pdomi2001/IOT_project/img/modulo_iot_sensore_dh11.jpg

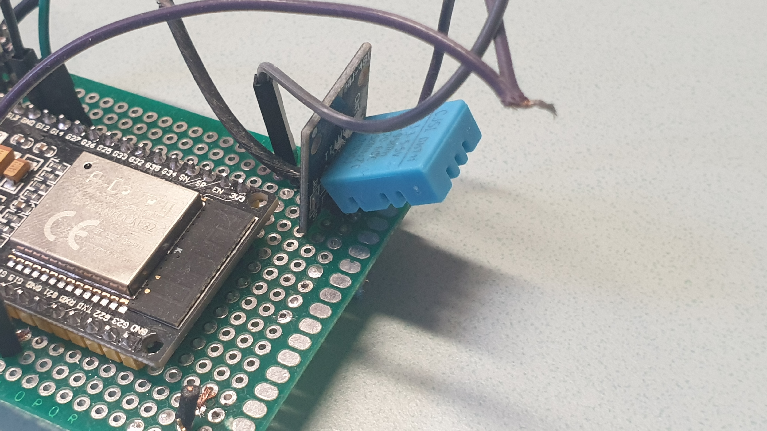
img/modulo_iot_sensore_dh11.jpg
