pdomi2001/IOT_project/img/modulo_iot_connettore.jpg

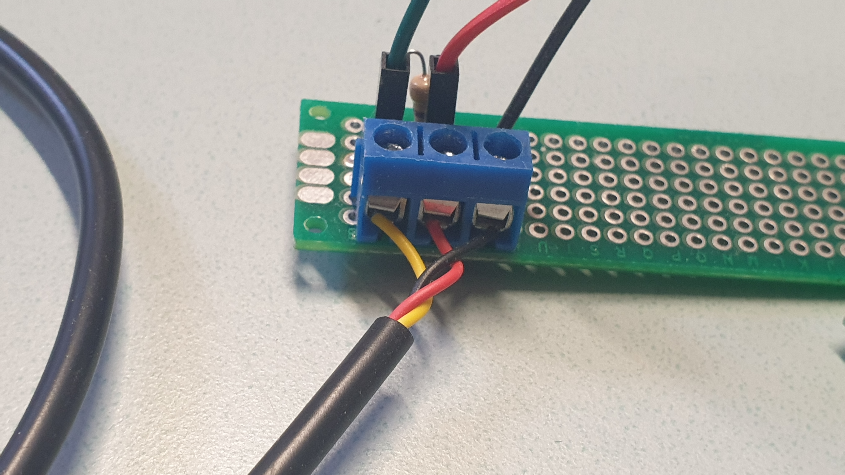
img/modulo_iot_connettore.jpg
