pdomi2001/IOT_project/presentazione/presentazione_progetto.pdf

# Esame di Internet of Things

# Stazione di rilevamento temperatura ed umidità

# Paride Dominici

# Scopo del progetto

# - Idea iniziale

# – Contabilizzatore di calore

# - Idea definitiva

# – Comparazione efficienza termosifone Vs pompa di calore

Esame di IOT – Paride Dominici | 2/27

# Contabilizzatore di calore/1

## La contabilizzazione del calore può essere effettuata nel modo seguente: 1.Si fissa una temperatura minima per considerare che il termosifone sia in funzione

2.Si fissa la differenza di tempo per far avanzare il conteggio.

## 3.Quando la temperatura rilevata supera la temperatura minima vuol dire che il

termosifone è acceso e quindi iniziamo a contare.

## 4.Finché la temperatura rimane al di sopra della temperatura minima ogni delta di

tempo facciamo avanzare il numero di elementi contati.

# Contabilizzatore di calore/2

# Caratteristiche di un contabilizzatore commerciale:

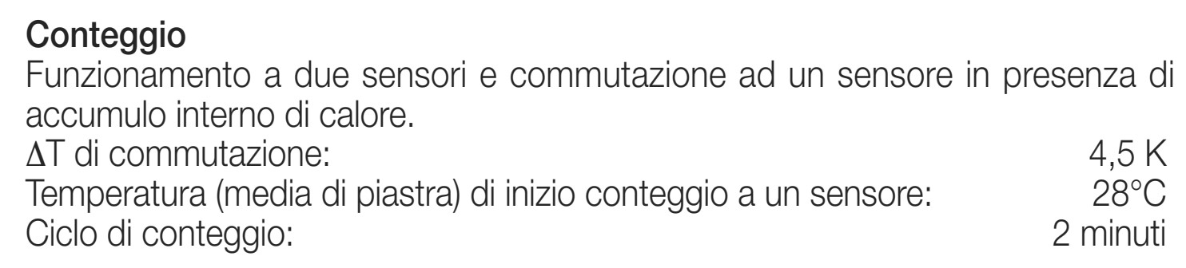
[picture p16: figure]
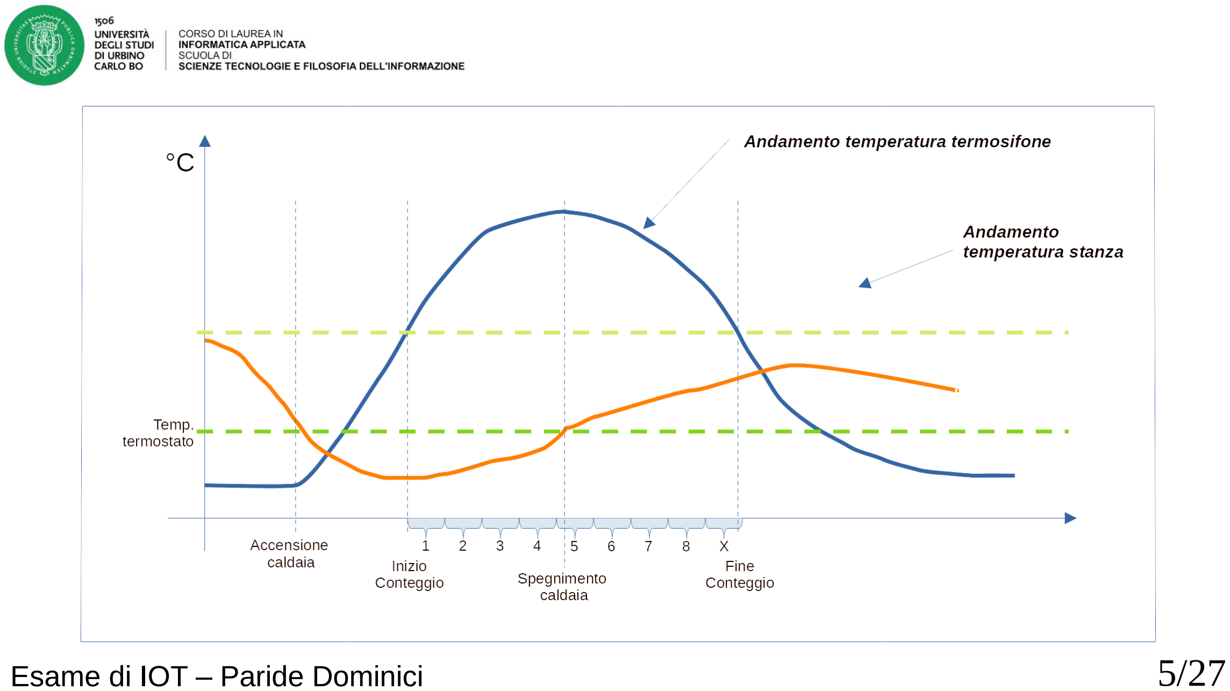
[picture p17: page 5]

# Comparazione efficienza di un termosifone contro efficienza di una pompa di calore

# Usiamo i differenti moduli per misurare le temperature del termosifone (idea iniziale) e dell’ambiente circostante e le

confrontiamo con quelle registrate dagli altri due moduli.

# Nello specifico facciamo un confronto tra l’efficienza del

termosifone e quella di una pompa di calore.
Il modulo lontano dai primi due serve come riferimento.

# Ambiente del test

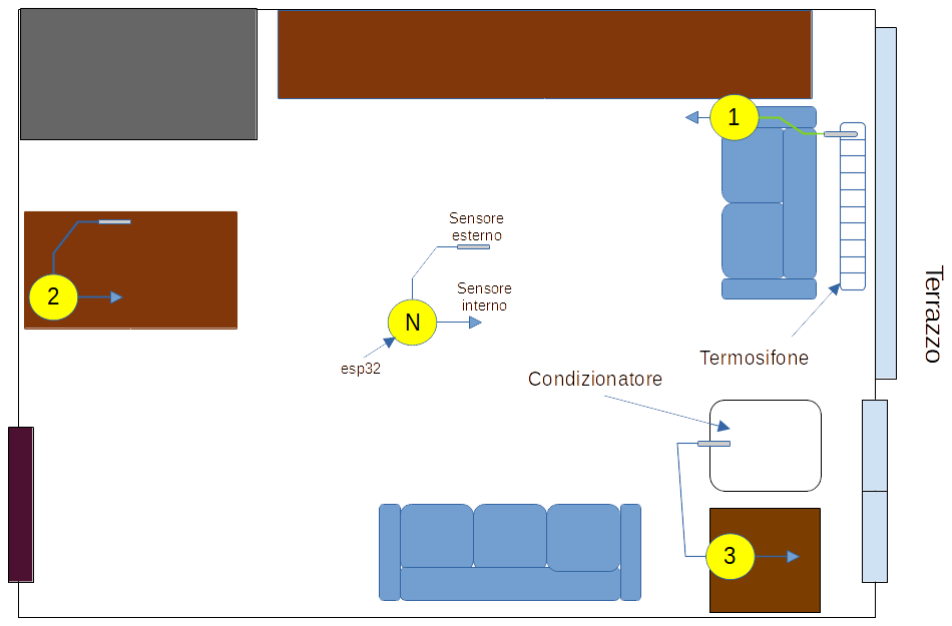
[picture p18: figure]

# Schema di collegamento dei moduli

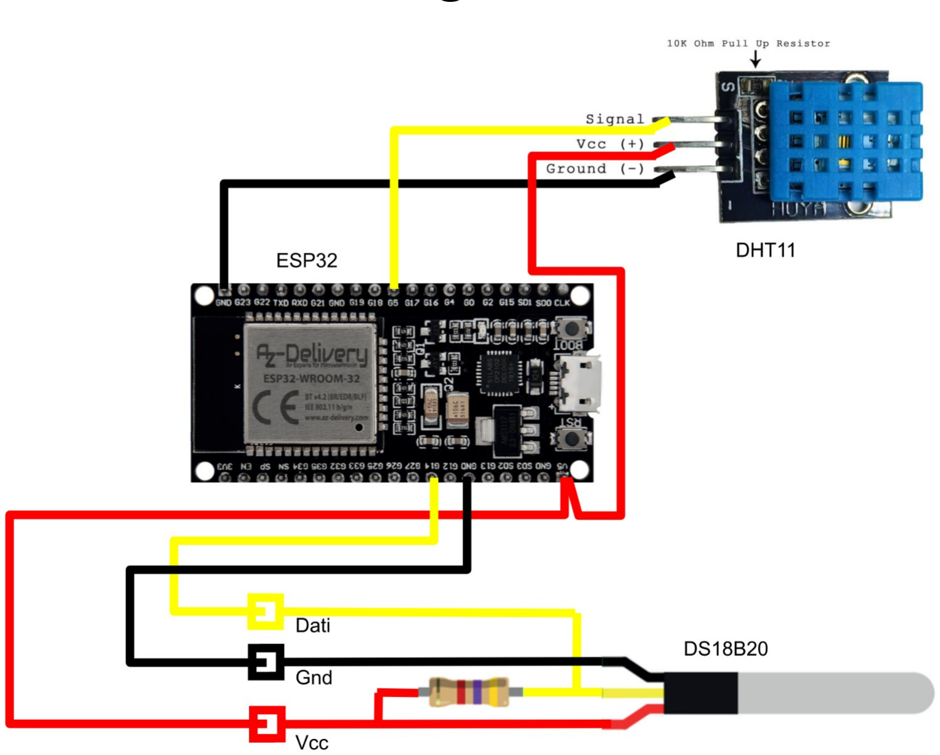
[picture p19: figure]

# Moduli/1

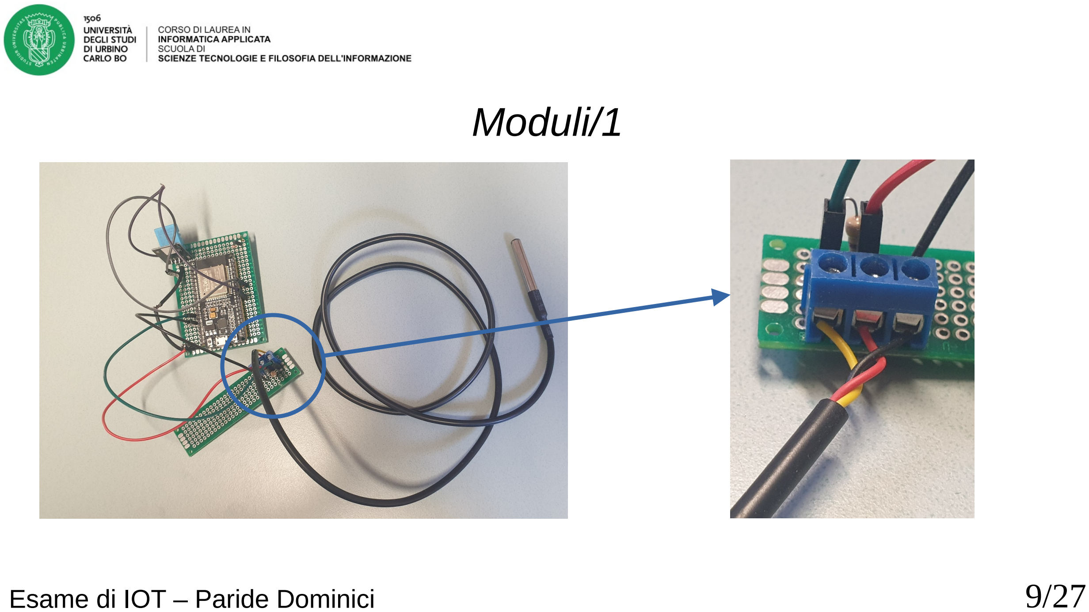
[picture p20: page 9]

# Moduli/2

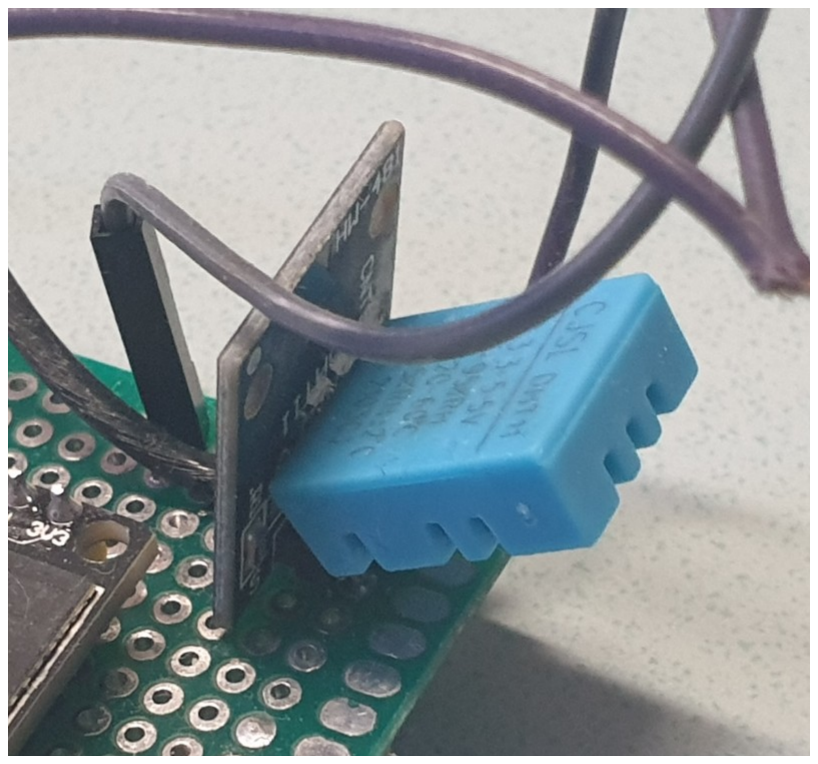
[picture p21: figure]
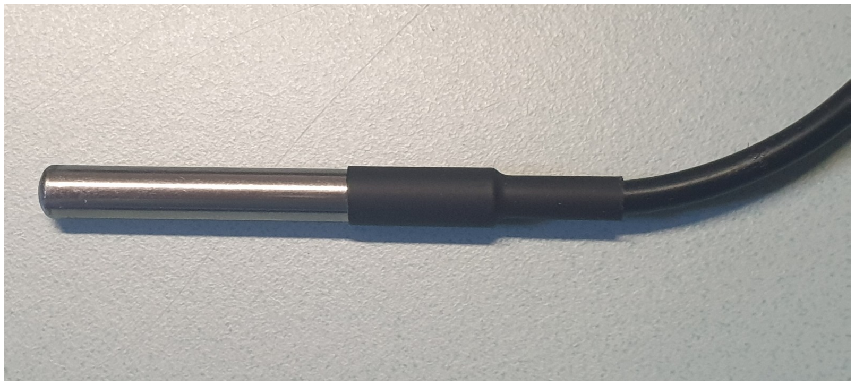
[picture p22: figure]

DS18B20 | DH11

# Modulo di ricezione dei dati/1

# - Access point WiFi

# – Servizio hostapd => Accetta le connessioni in entrata – Servizio dnsmasq => distribuisce gli indirizzi IP in modo dinamico con DHCP – Per collegarci usiamo ssh e vnc

# Modulo di ricezione dei dati/2 - Servizi di ricezione dati dai moduli

# – Tentativo di installazione InfluxDB (su architettura arm solo versione < 2.0) – Installazione broker MQTT (mosquitto) – Creazione del subscriber che raccoglie i dati (python)

## - Libreria python paho-mqtt

# – Analisi dei dati

## - Utilizzo di Pandas e Matplotlib

# Modulo di trasmissione dei dati/1

# - Usiamo delle esp32

# – Tentativo di installazione InfluxDB (solo versione < 2.0 su architettura arm) – Installazione broker MQTT (mosquitto) – Creazione dei subscriber (python)

## - Libreria python paho-mqtt

# – Analisi dei dati

## - Utilizzo di Pandas e Matplotlib

# Modulo di trasmissione dei dati/2

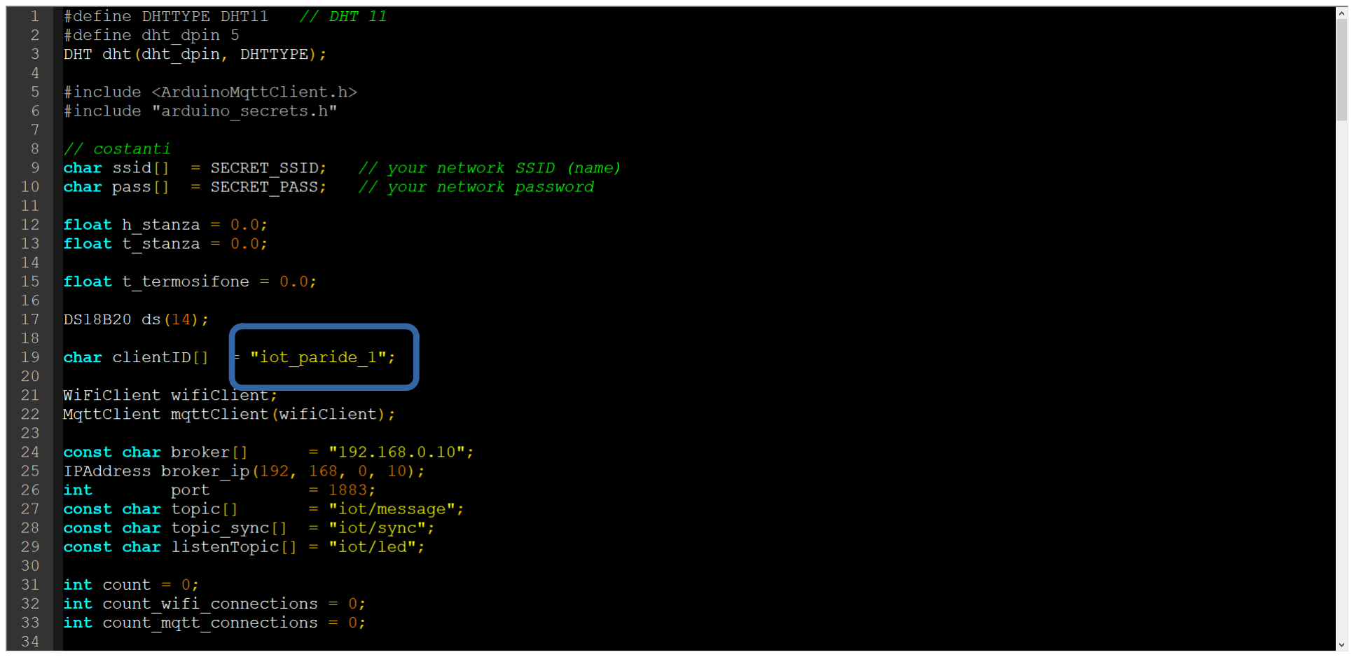
[picture p23: figure]

# Subscriber MQTT/1

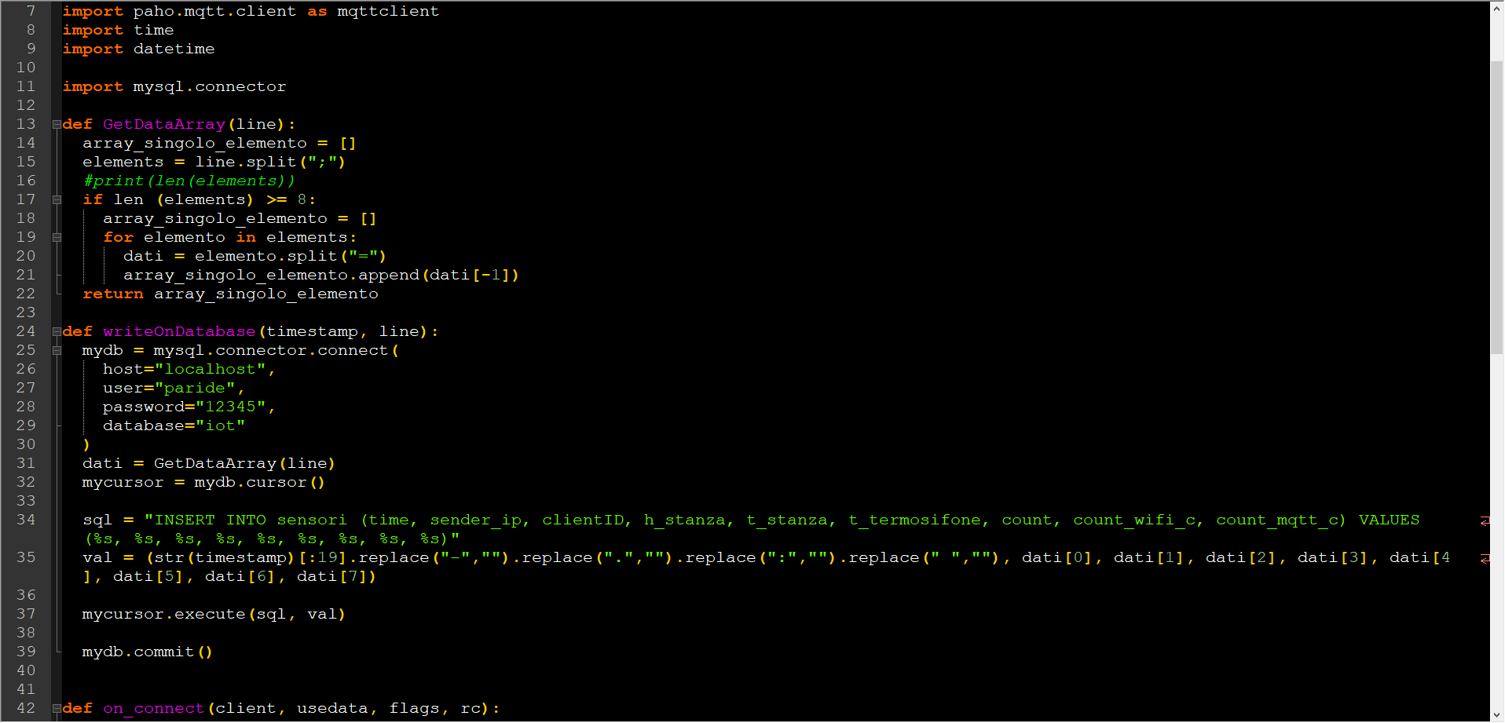
[picture p24: figure]

# Subscriber MQTT/2

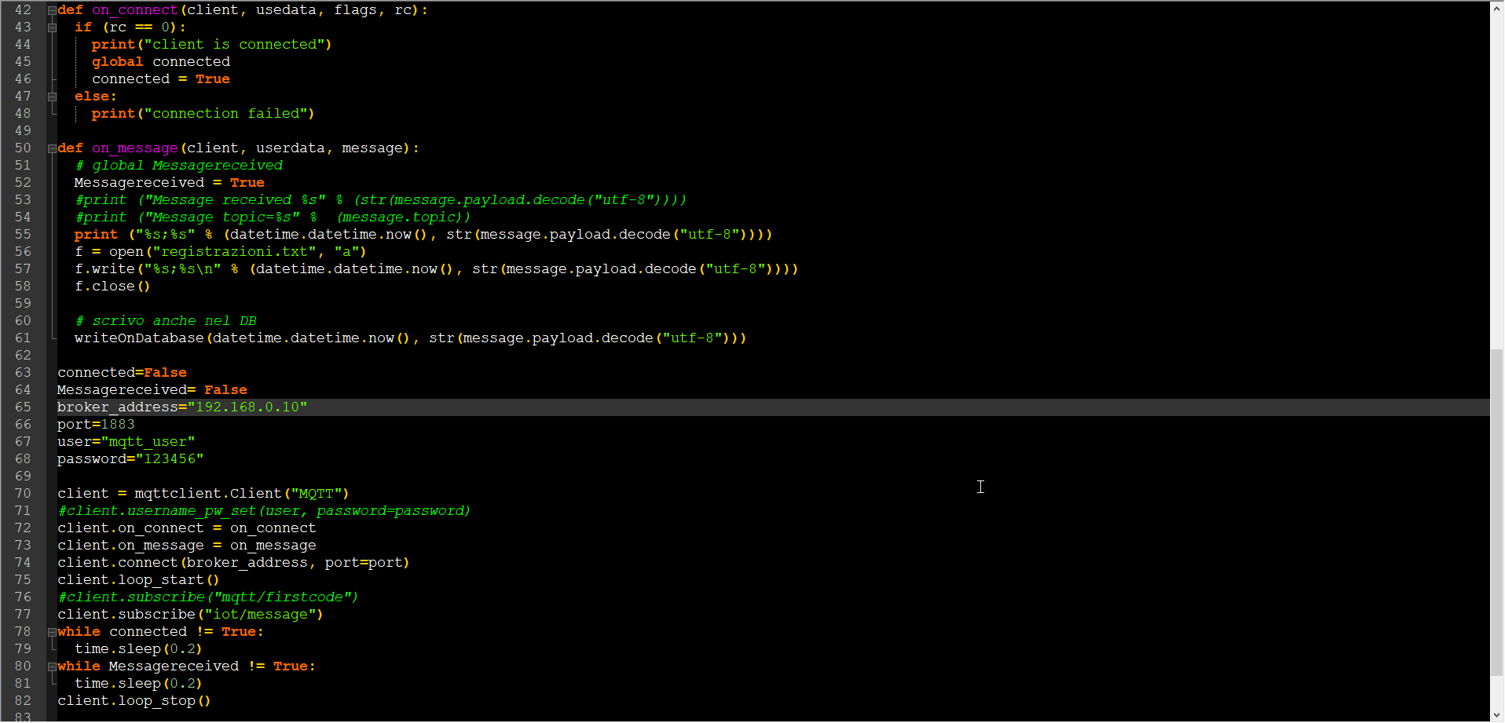
[picture p25: figure]

# File di testo con i dati ricevuti

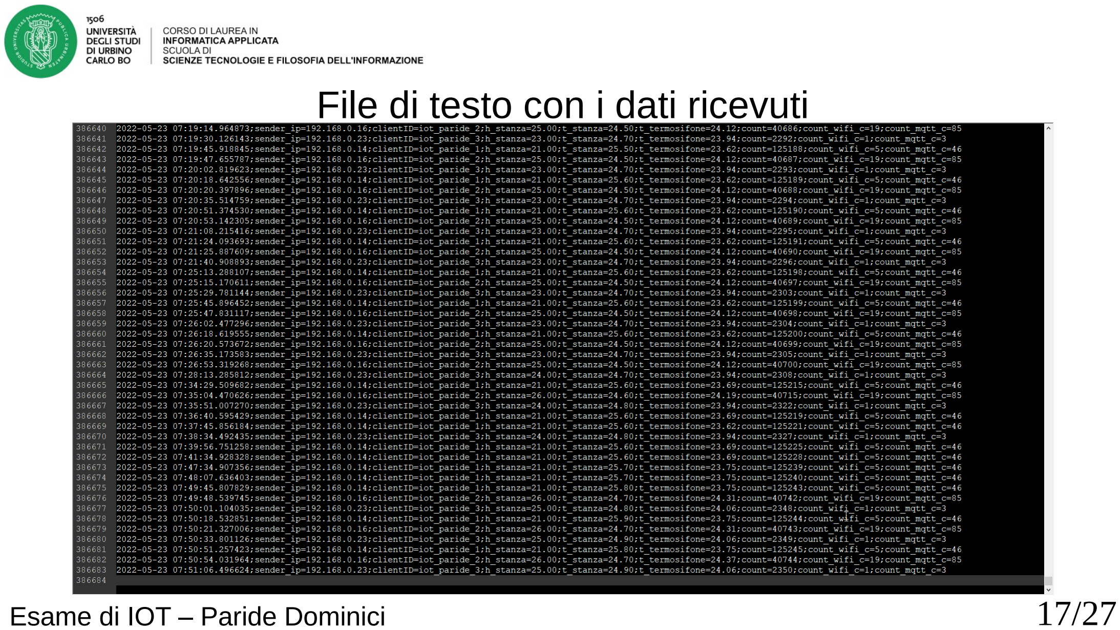
[picture p26: page 17]

# Convertitore del file per Pandas

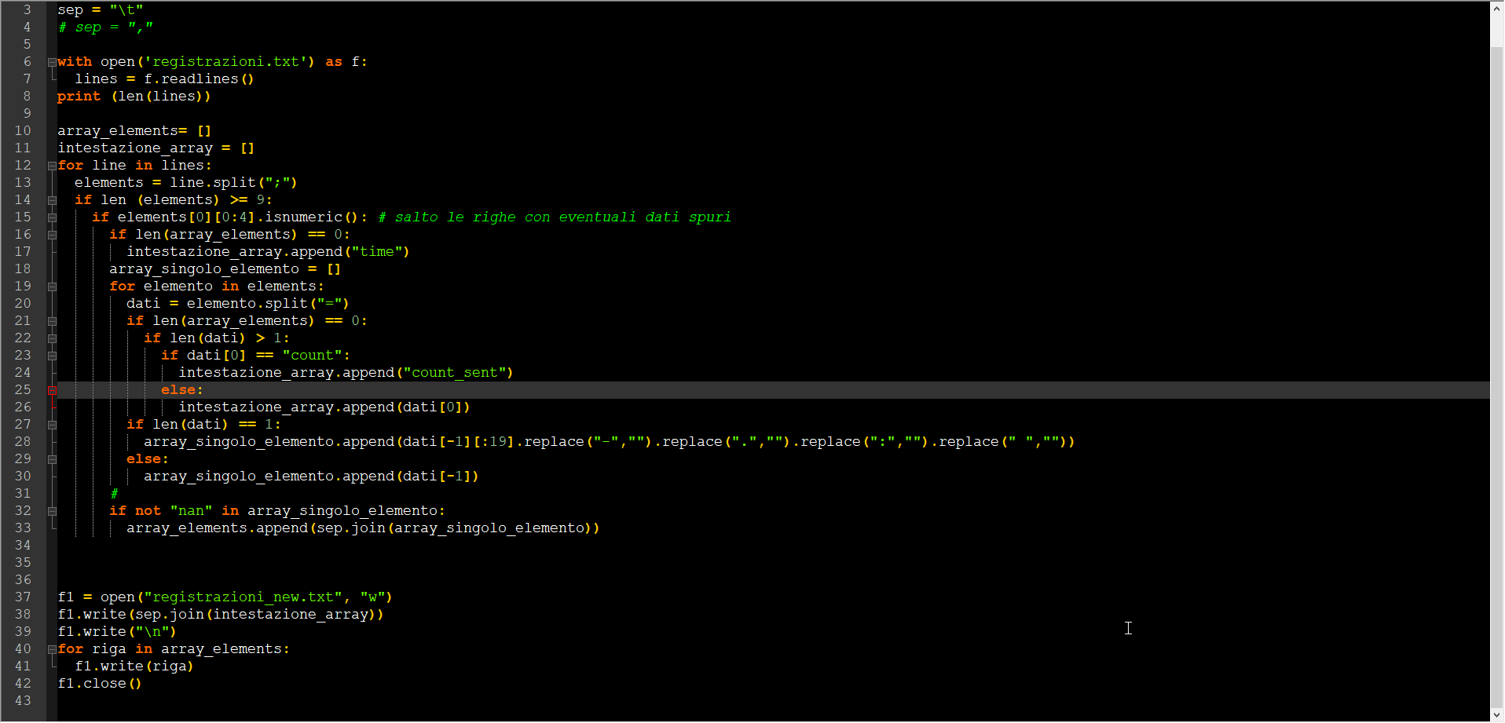
[picture p27: figure]

# File dei dati pronto per essere usato da Pandas

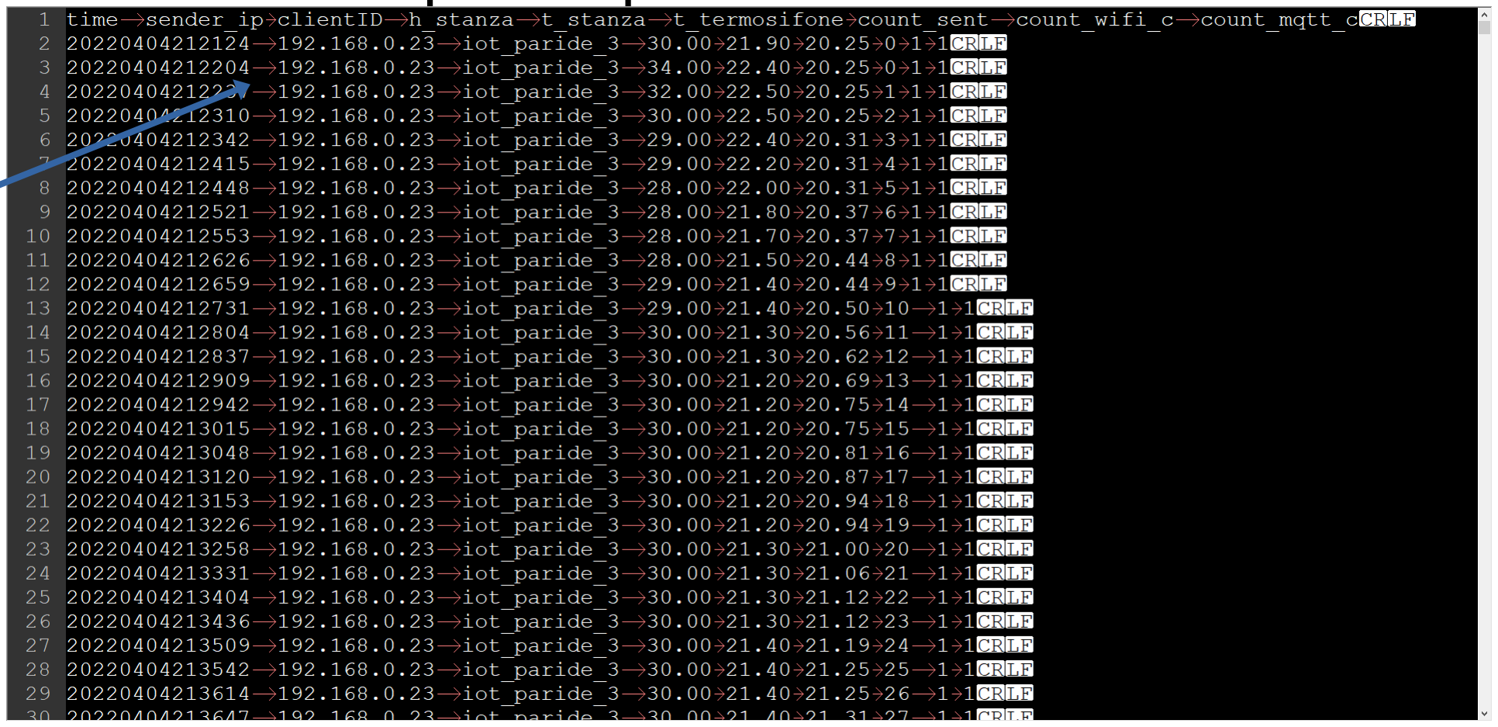
[picture p28: figure]

Tab

# Esempio di analisi dei dati/1

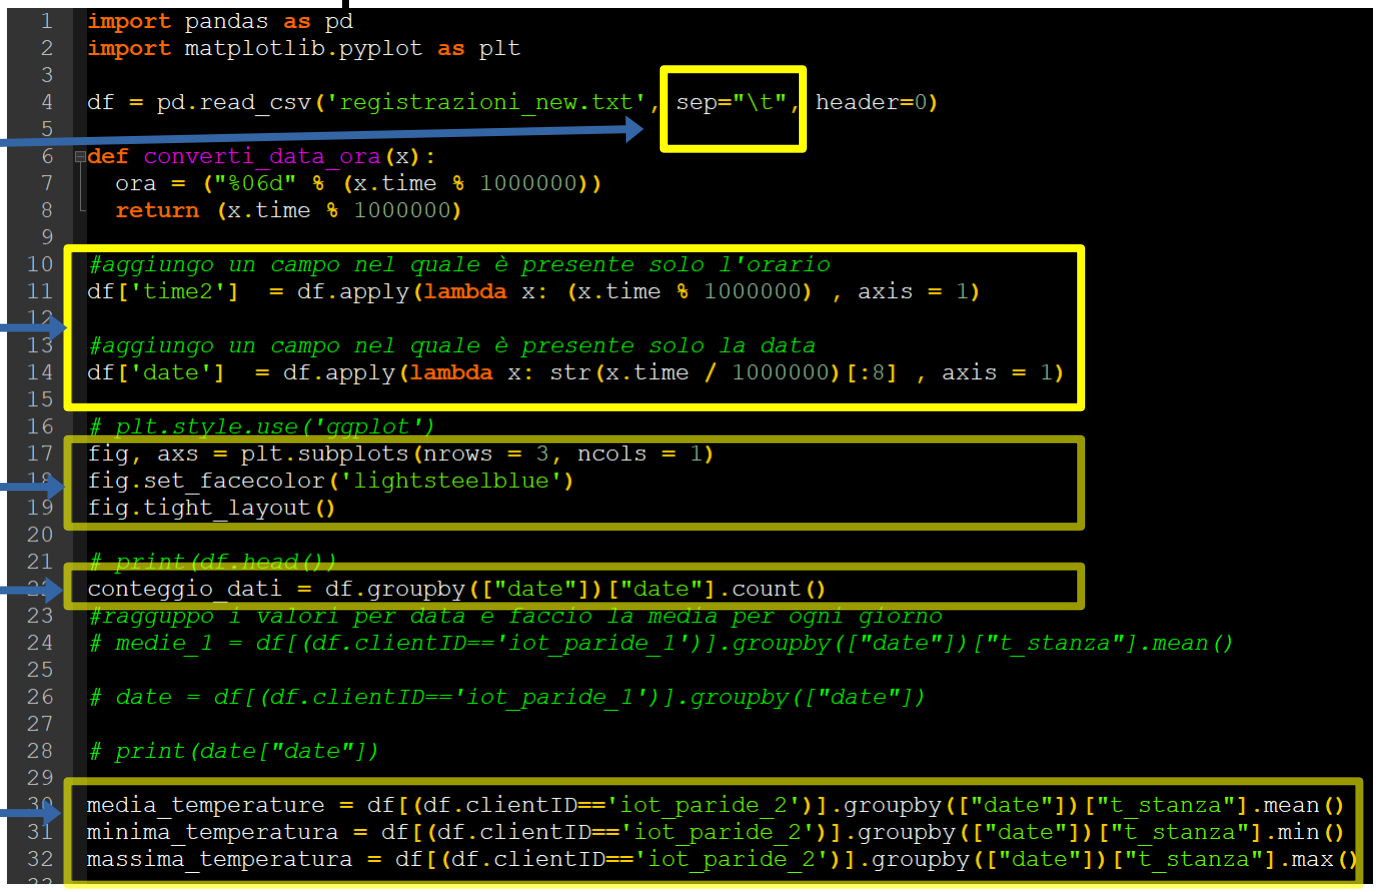
[picture p29: figure]

Tabulazione per
separare i campi

Aggiungo i campi
che mi servono

Creo una figura con
tre grafici

Calcolo il numero di dati
ricevuti ogni giorno

Calcolo media, massima
e minima delle
temperature giornaliere
per ogni sensore dht11

# Esempio di analisi dei dati/2

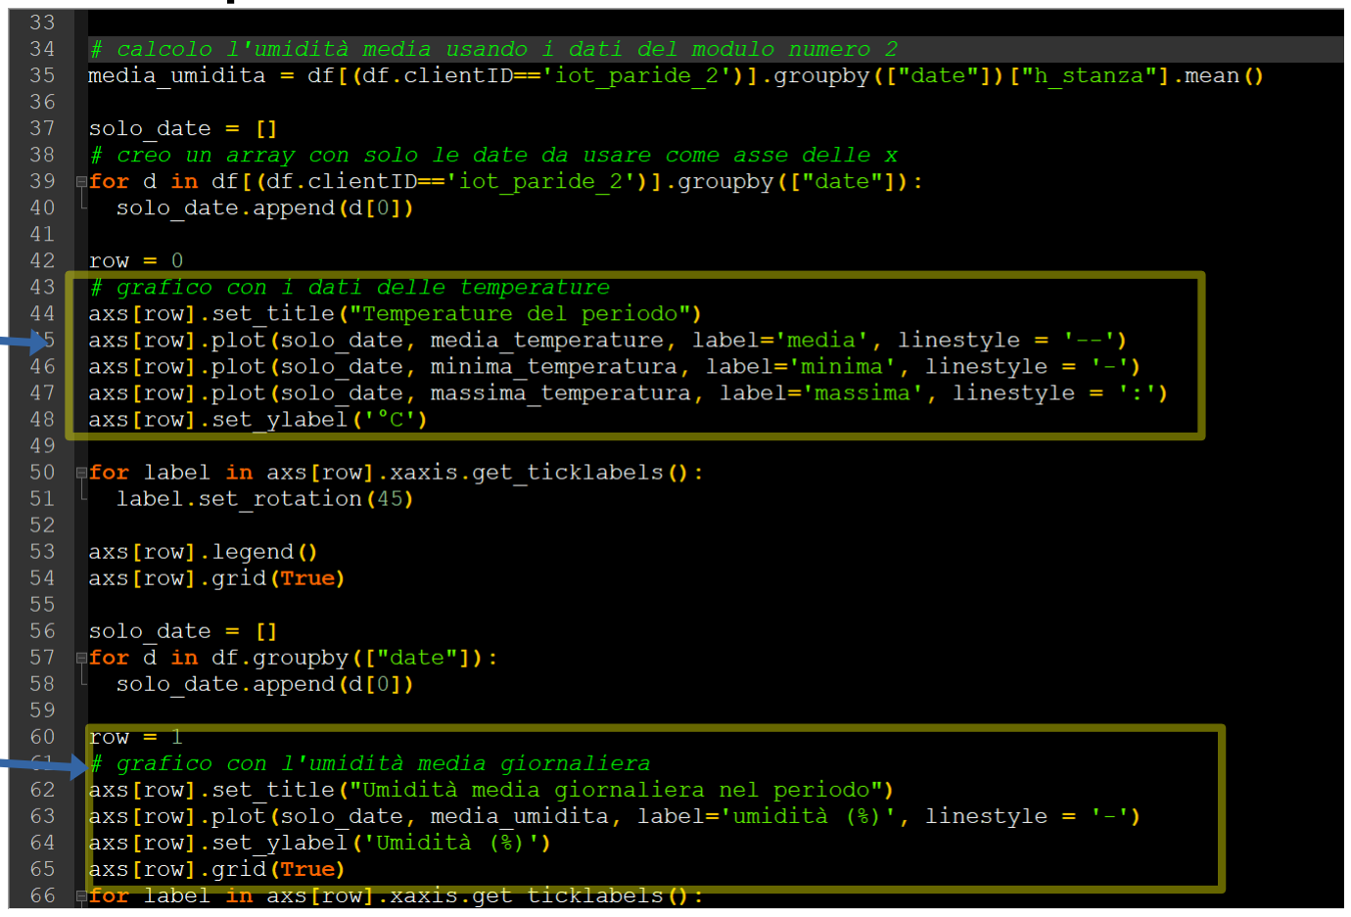
[picture p30: figure]

Grafico delle
temperature

Grafico dell’umidità

# Esempio di analisi dei dati/3


# Problemi con la connessione

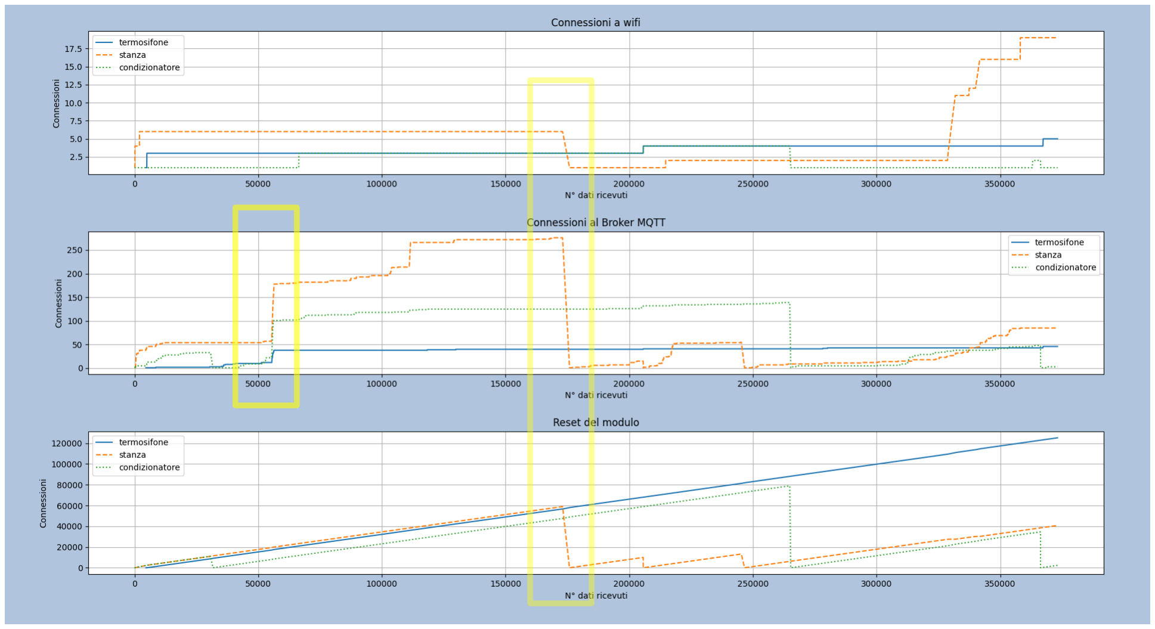
[picture p31: figure]

# Confronto efficienza


# Confronto efficienza

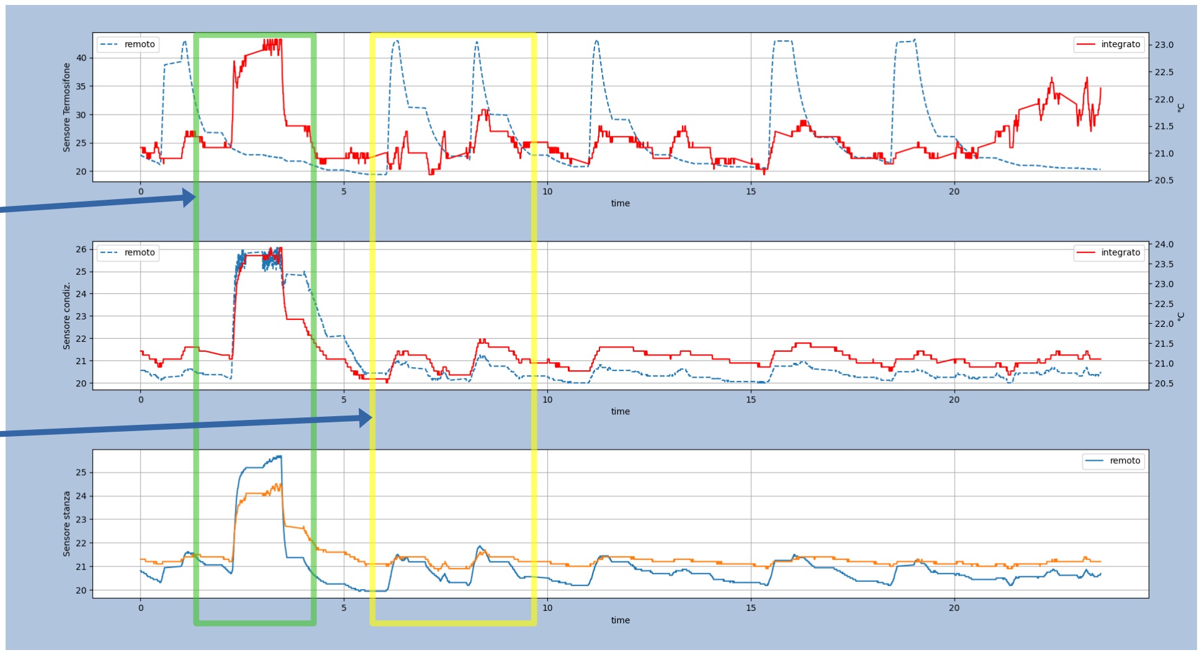
[picture p32: figure]

Accensione
pompa di calore

Accensione
termosifone

# Conclusioni

# Risorse

E’ possibile scaricare tutti i file del progetto dal repository https://github.com/pdomi2001/IOT_project

I file presenti sono:
- mqtt_subscriber.py: Questo script resta in ascolto sul server MQTT e scrive le rilevazioni
- converti_dati.py: Converte i dati ricevuti in un formato che sia leggibile da Pandas
- analisi_dati_connessioni.py: Analizza i dati relativi alle connessioni effettuate dai moduli e crea una serie di grafici che indicano le riconnessioni nell'intero periodo.
- analisi_dati_periodo_intero.py: Analizza i dati relativi alle temperature medie giornaliere e l'umidità media giornaliera.
- analisi_dati_termico.py: Analizza i dati relativi ad un dato giorno (nel nostro caso il 14 aprile 2022) e mostra gli andamenti, durante la giornata delle temperature registrate dai sensori interni e dalle sonde dei moduli.
- progetto_esp.ino: Progetto per Arduino da caricare sulla ESP32
- arduino_secrets.h: File che contiene le informazioni per far connettere alla rete WIFI la ESP32

Più i file accessori dei grafici generati e degli schemi presenti in questo documento.
