pdomi2001/IOT_project/img/grafico_contabilizzazione.png

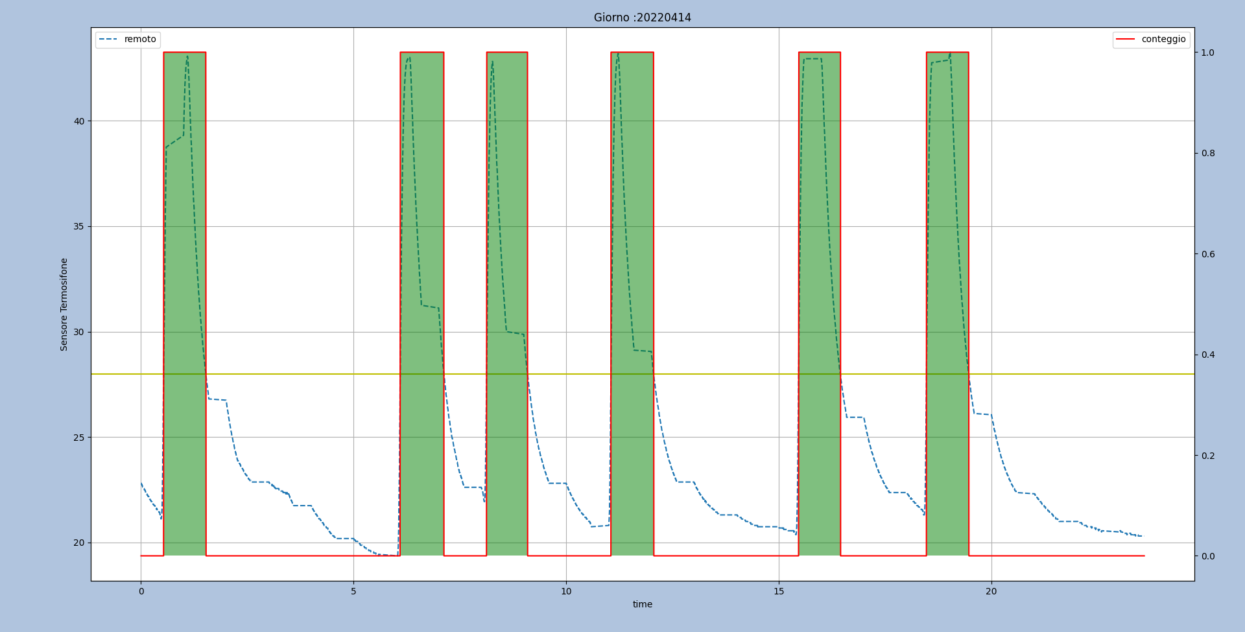
img/grafico_contabilizzazione.png
