pdomi2001/IOT_project/img/modulo_iot_intero.jpg

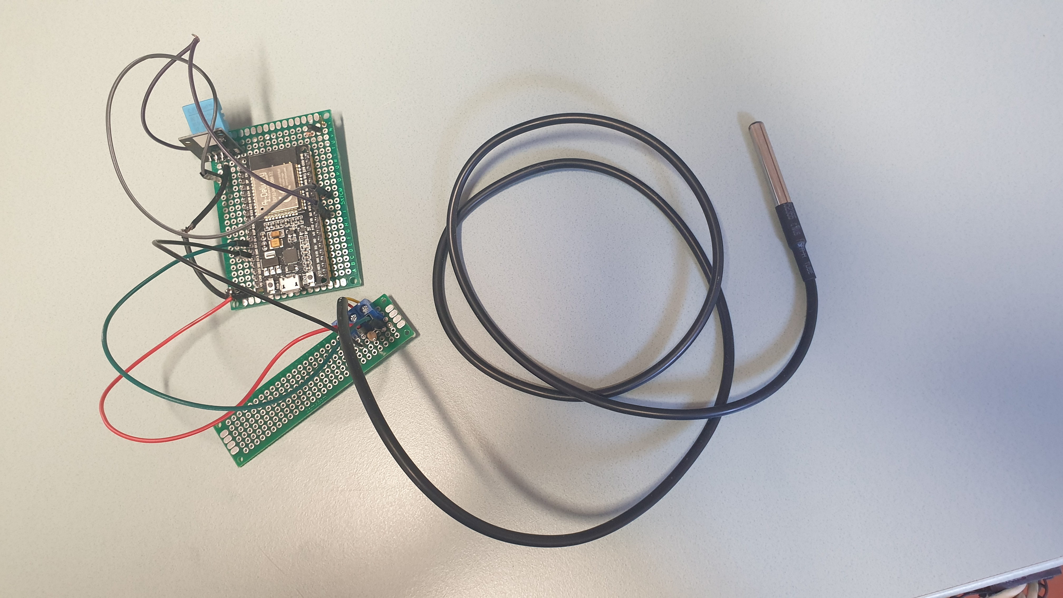
img/modulo_iot_intero.jpg
