pdomi2001/IOT_project/img/modulo_iot_sonda.jpg

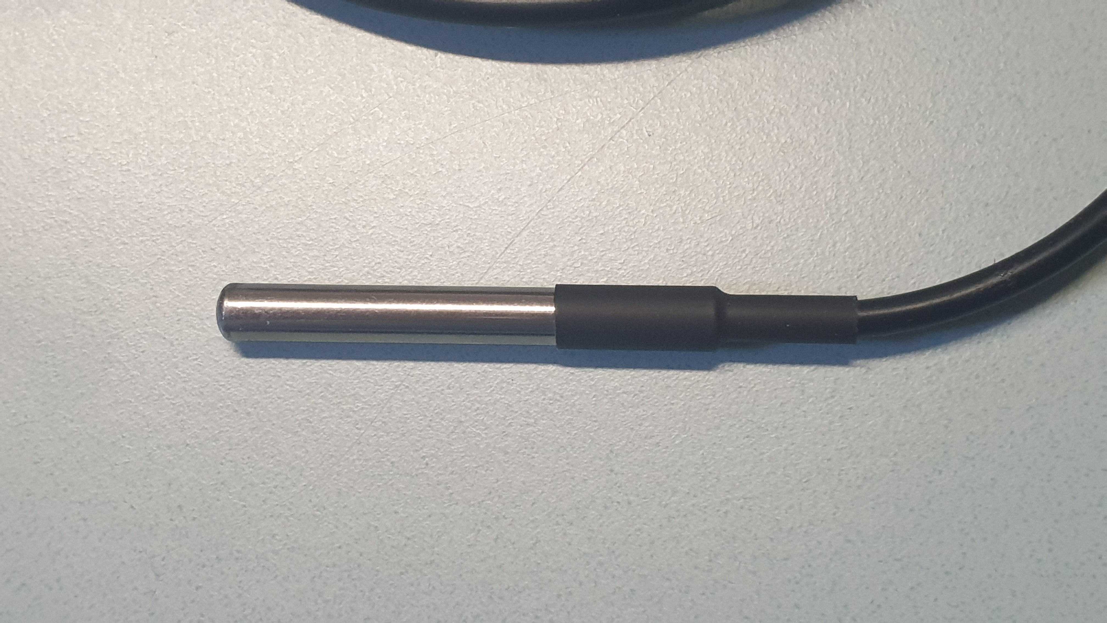
img/modulo_iot_sonda.jpg
