pdomi2001/IOT_project/src/Funzionamento contabilizzatori di calore.png

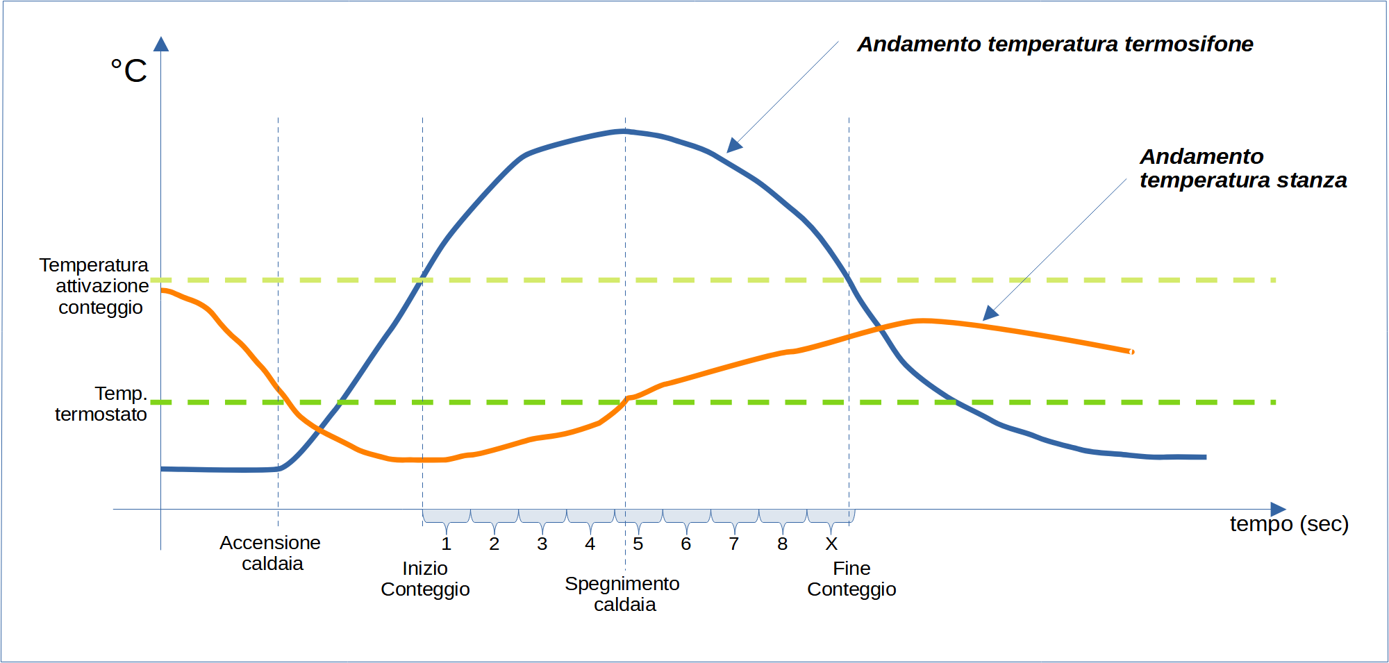
src/Funzionamento contabilizzatori di calore.png
