pdomi2001/IOT_project/src/Schema salotto.png

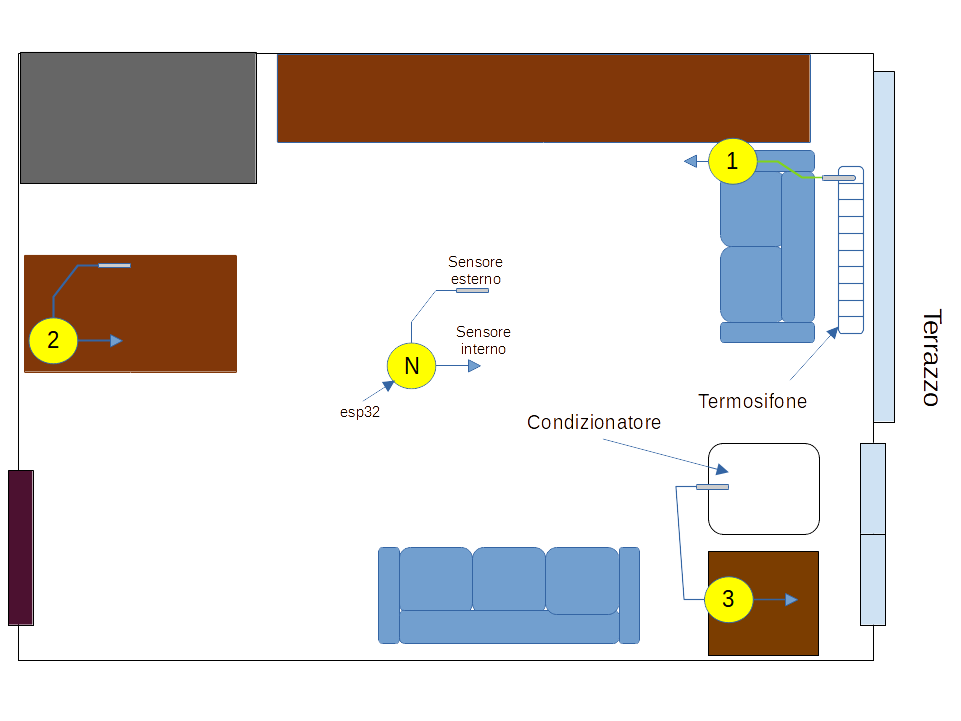
src/Schema salotto.png
