pdomi2001/IOT_project/(commit log)

2022-06-04 * File necessari per la scrittura della relazione * file per l'analisi dei dati
2022-06-04 Modificato nome di una colonna che dava problemi con Pandas
    [converti_dati.py]
2022-06-06 * Aggiornato schema contabilizzatori di calore * aggiunto schema collegamenti modulo dei sensori
2022-06-06 * prima versione (incompleta) delle slide per la presentazione
2022-06-06 * corretto refuso nel grafico del funzionamento dei contabilizzatori di calore aggiunti file relazione
2022-06-07 versione aggiornata con la scrittura sul database mysql
2022-07-27 aggiunte opzioni di esecuzione e tolti messaggi inutili
2022-07-28 Correzione errori e aggiunta visualizzazione graf.
    [calcolo_contabilizzazione_calore.py]
2022-08-03 Aggiunto grafico della contabilizzazione e modificato readme.md per indicare il nuovo file che fa la la contabilizzazione del calore ex-post
